jngdan/JWS/(commit log)

2024-10-05 Add files via upload
    Firmware JWS v1.0 for ESP32
2024-10-05 Add files via upload
    JWS v1.0 compiled binary code for ESP32 (first release OCT, 5 2024)
2024-10-14 Update JWS_v1-1_SH1106.ino
    Better stability...
    [JWS_v1-1_SH1106.ino]
